kc-GitHub/MotorControl/Images/Motor_mit_Elektronik_2.jpg

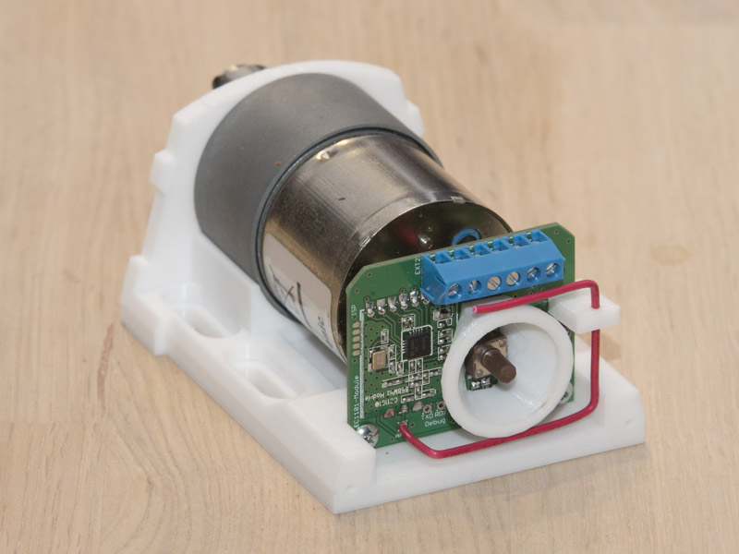
Images/Motor_mit_Elektronik_2.jpg
