kc-GitHub/MotorControl/Images/Vorhang_links.jpg

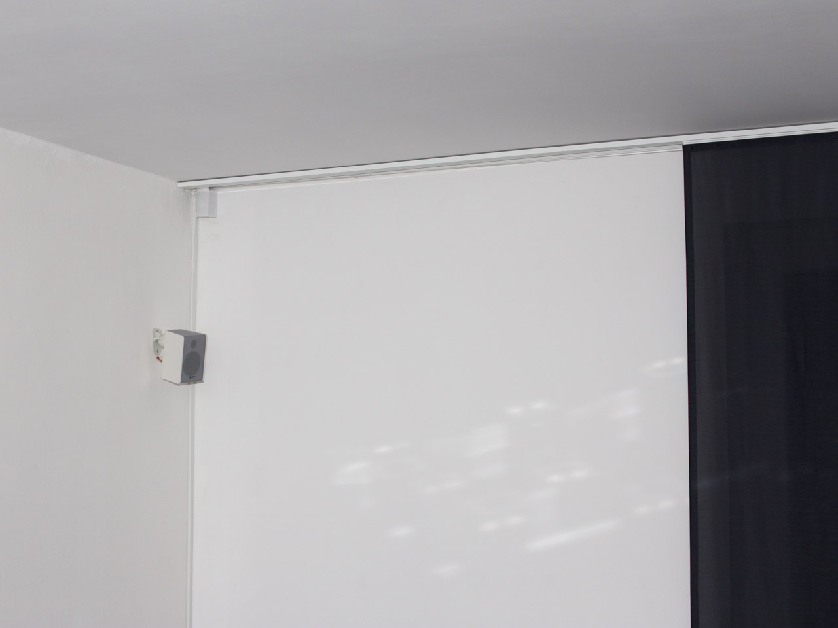
Images/Vorhang_links.jpg
