kc-GitHub/MotorControl/README.md

Firmware HM Motor-Control
===================================

#Changelog#

## First Version: 0.01 (Beta)##
 * First Commit
