kc-GitHub/MotorControl/Schematic/HM-Motor-Blind-Control_Schematic.pdf

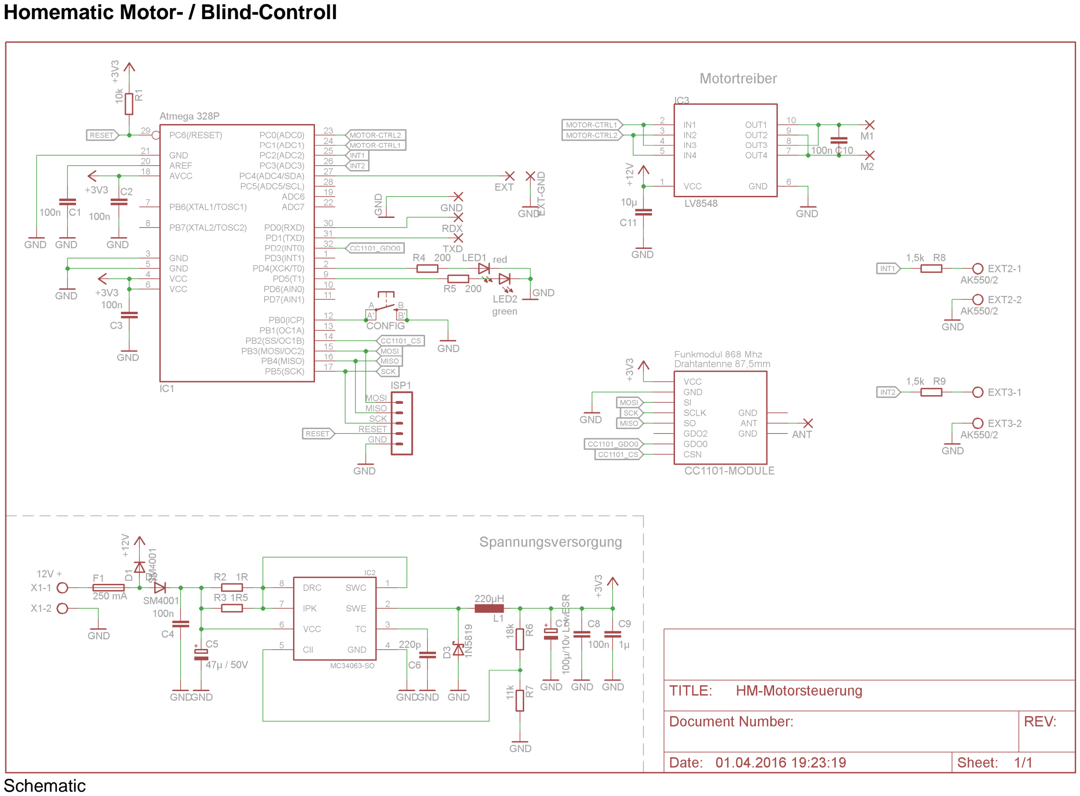
[picture p3: page 1]

Homematic Motor- / Blind-Controll

Schematic

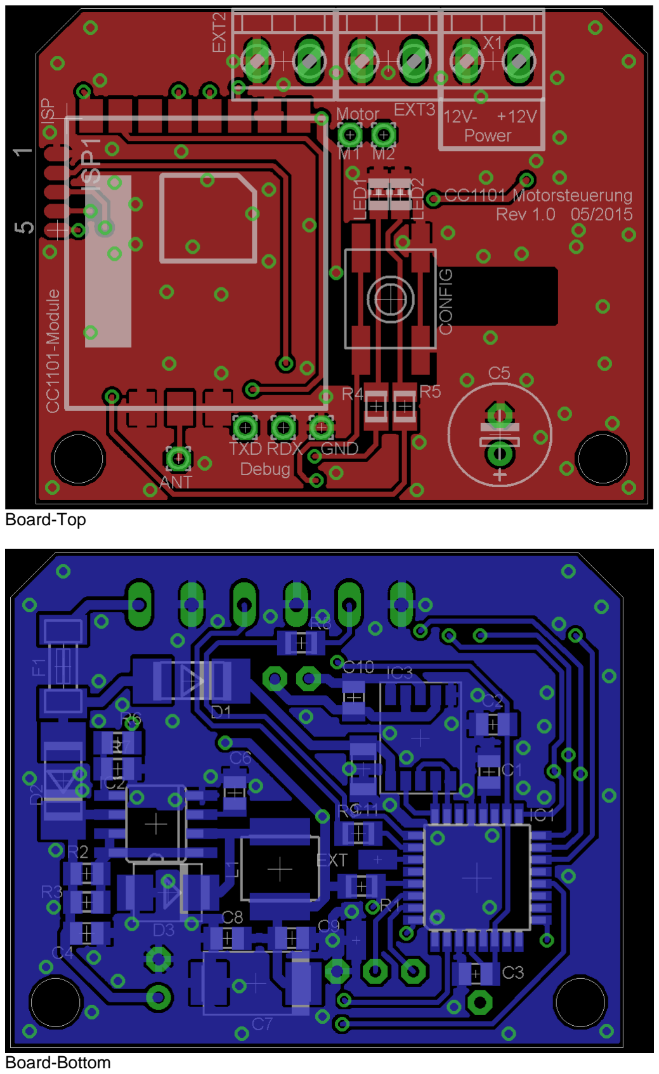
[picture p4: page 2]

Board-Top

Board-Bottom
