kc-GitHub/MotorControl/Images/Gehaeuse_Einzelteile.jpg

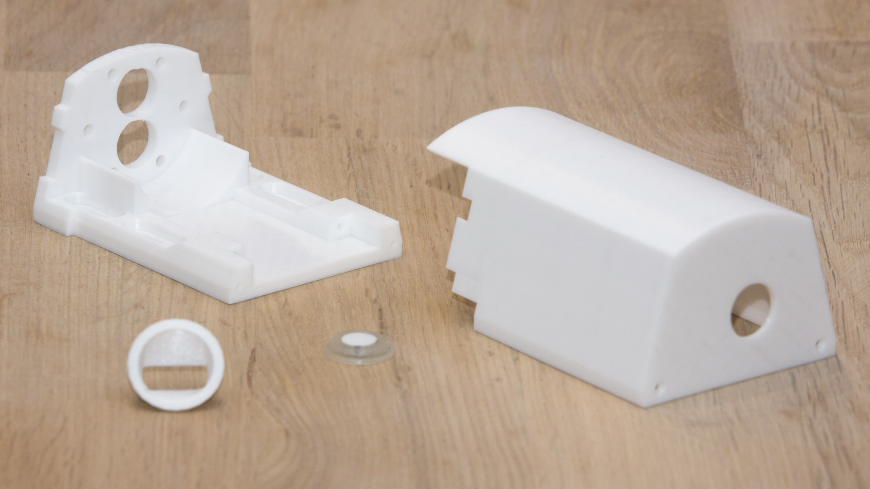
Images/Gehaeuse_Einzelteile.jpg
