kc-GitHub/MotorControl/Images/Gehaeuse_geschlossen.jpg

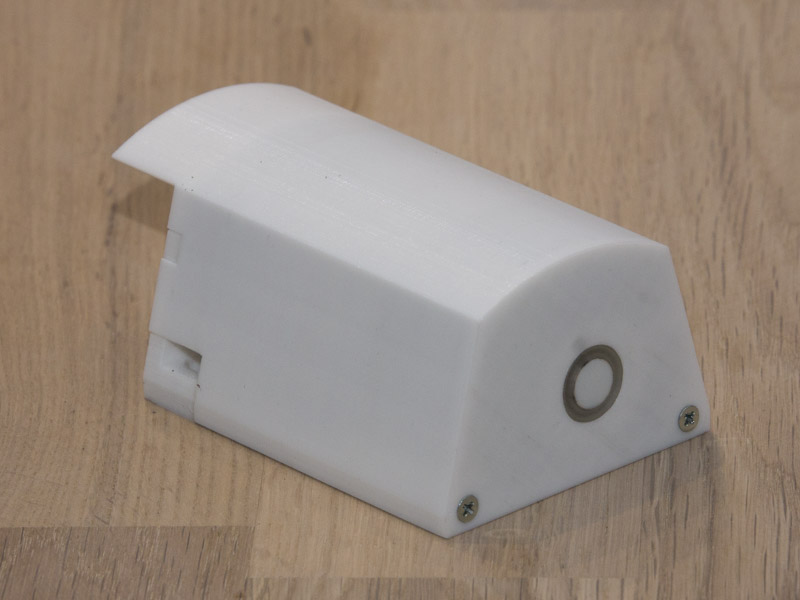
Images/Gehaeuse_geschlossen.jpg
