kc-GitHub/MotorControl/Images/Gehaeuse_geschlossen_rechts.jpg

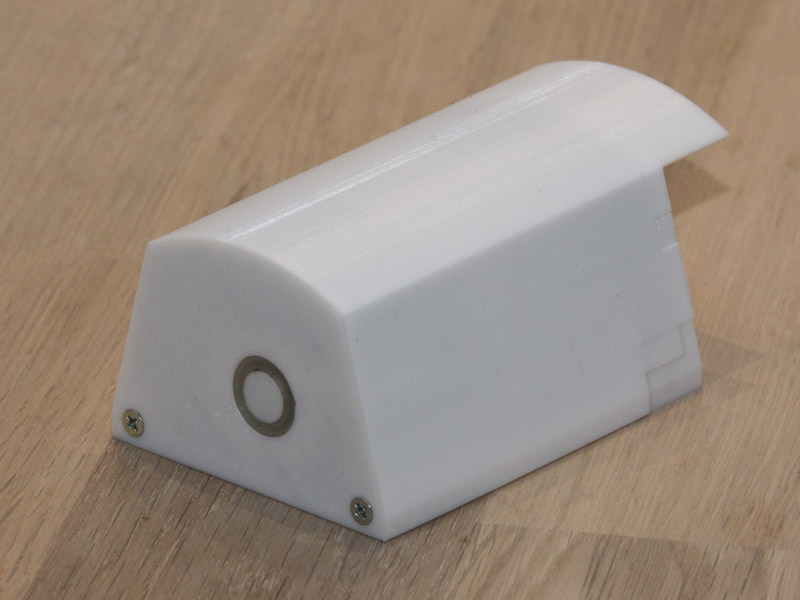
Images/Gehaeuse_geschlossen_rechts.jpg
