kc-GitHub/MotorControl/Images/Motor_mit_Elektronik.jpg

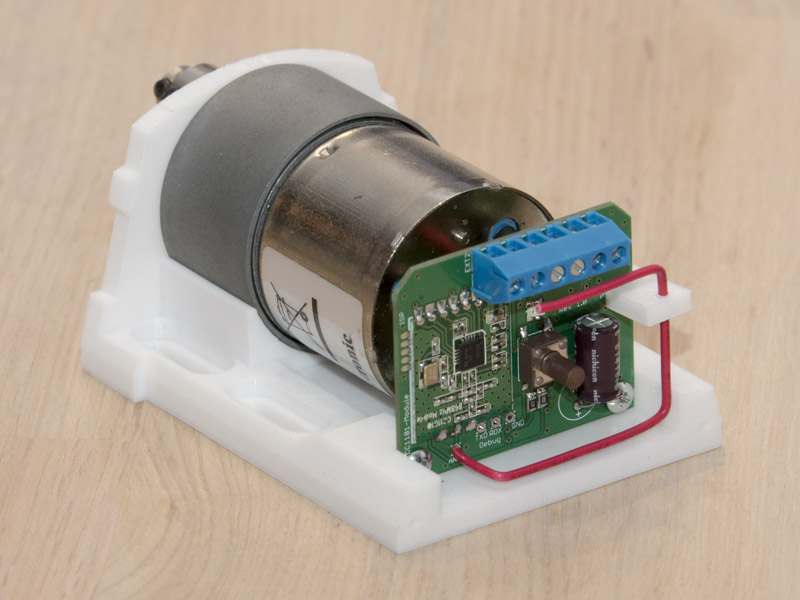
Images/Motor_mit_Elektronik.jpg
