kc-GitHub/MotorControl/Images/Motor_mit_Elektronik_3.jpg

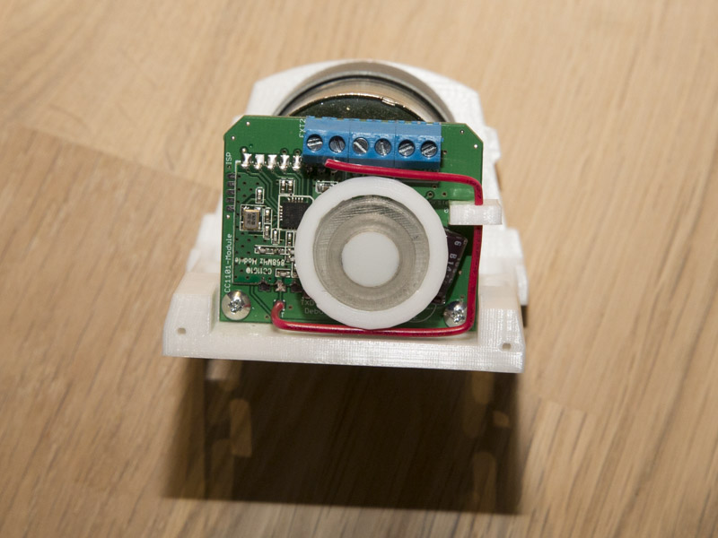
Images/Motor_mit_Elektronik_3.jpg
