kc-GitHub/MotorControl/Images/Motor_mit_Elektronik_vorn.jpg

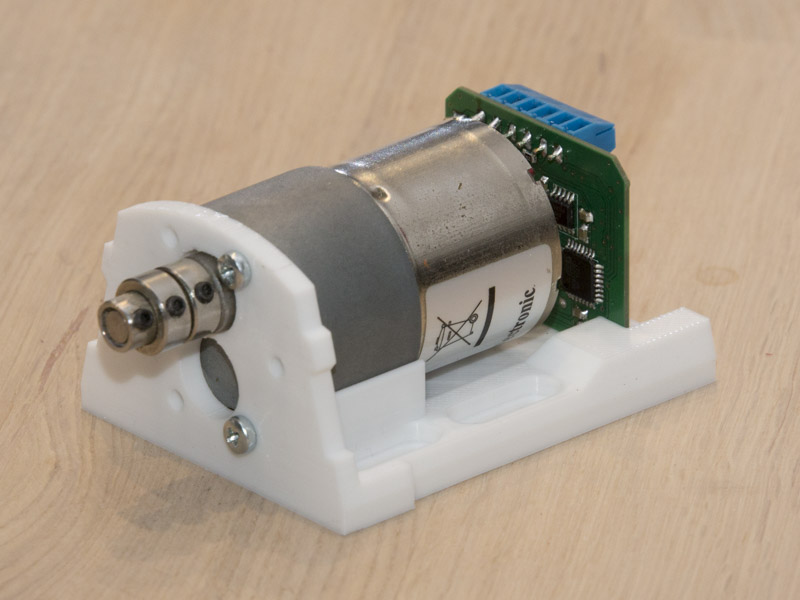
Images/Motor_mit_Elektronik_vorn.jpg
