kc-GitHub/MotorControl/Images/Motor_vorne.jpg

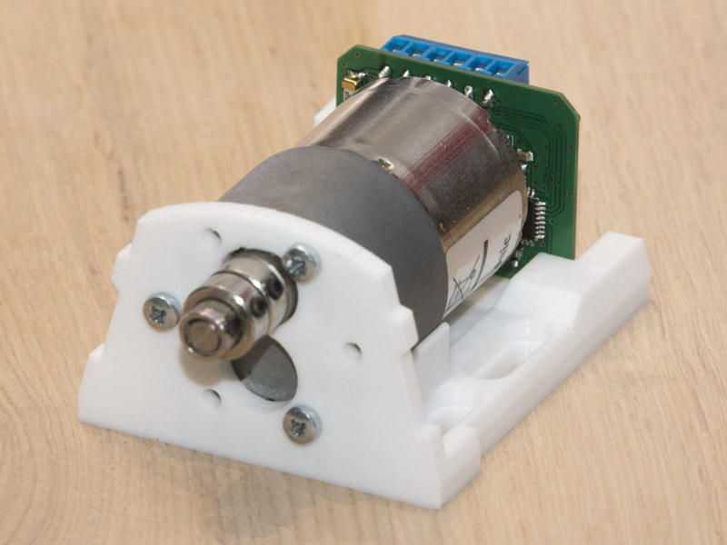
Images/Motor_vorne.jpg
