kc-GitHub/MotorControl/Images/Platine_Rueckseite.jpg

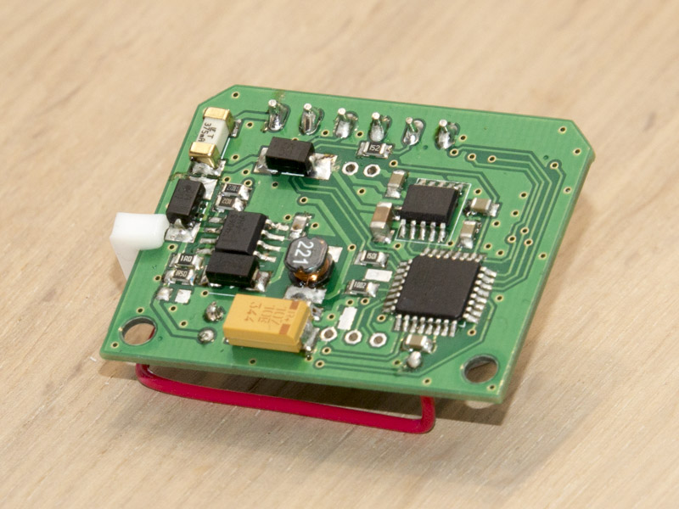
Images/Platine_Rueckseite.jpg
