kc-GitHub/MotorControl/Images/Platiner_oben.jpg

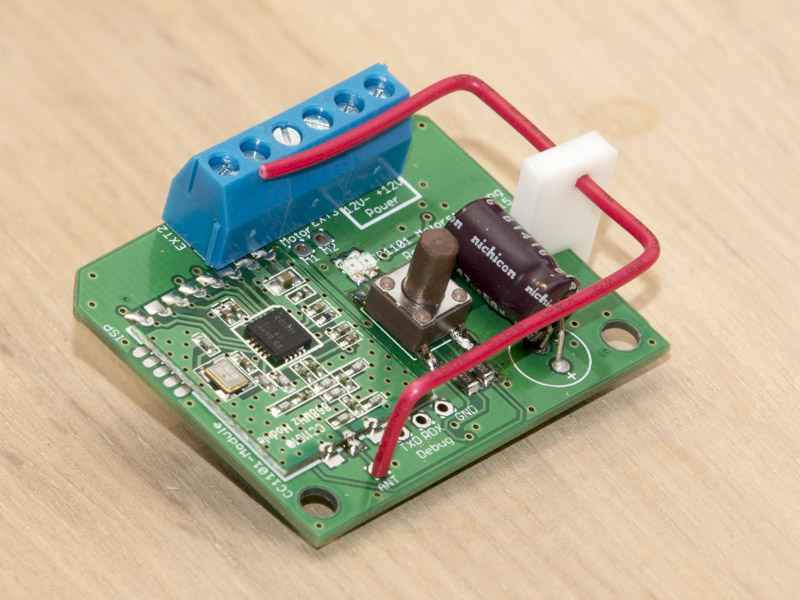
Images/Platiner_oben.jpg
