kc-GitHub/MotorControl/Images/Umlenkrolle.jpg

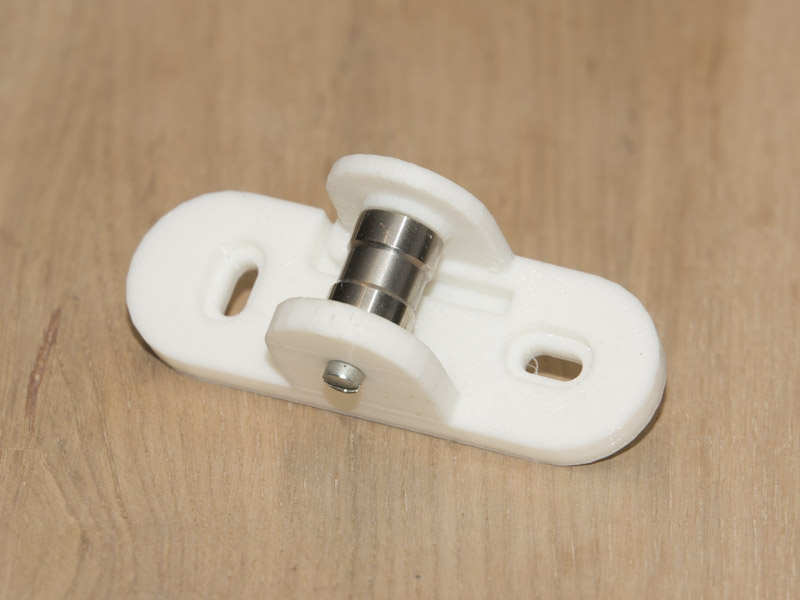
Images/Umlenkrolle.jpg
