kc-GitHub/MotorControl/Images/Umlenkrolle_mit_Reedkontakt.jpg

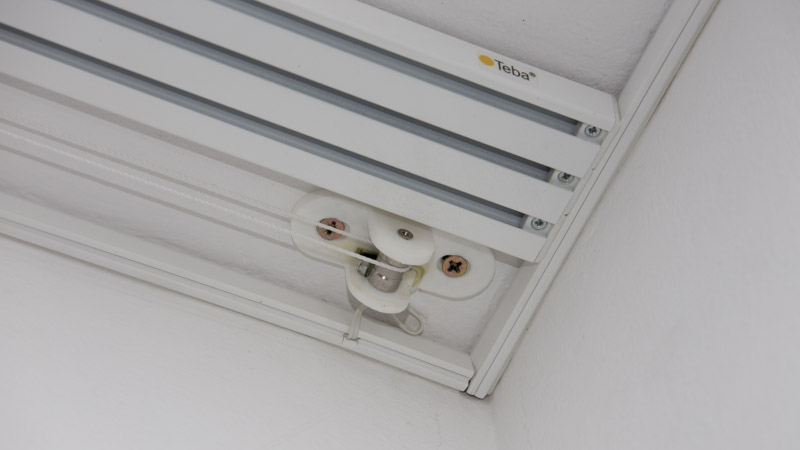
Images/Umlenkrolle_mit_Reedkontakt.jpg
