kc-GitHub/MotorControl/Images/Vorhang_rechts.jpg

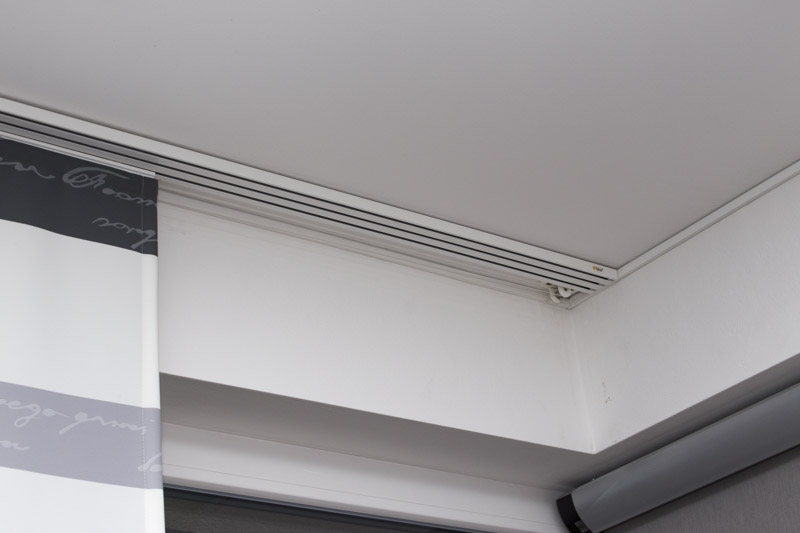
Images/Vorhang_rechts.jpg
