kc-GitHub/MotorControl/3D-PrintFiles/STL/Bearing-Holder.stl

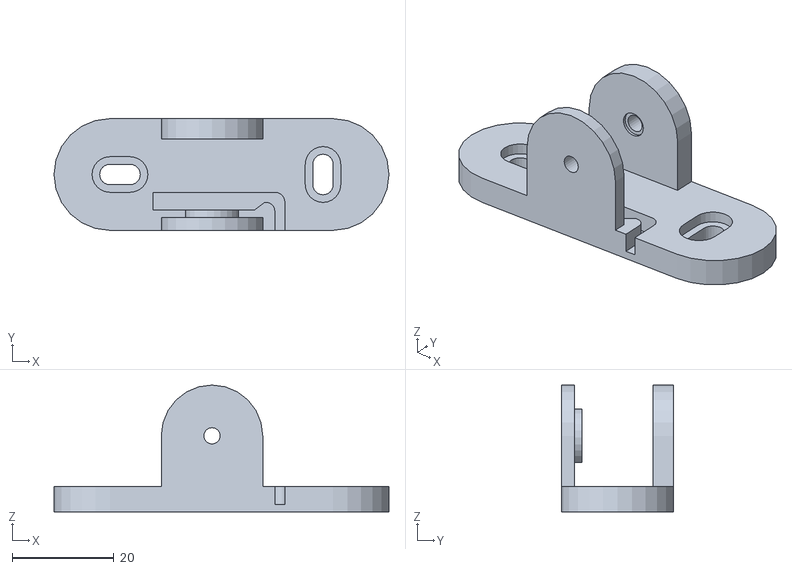
[picture p17: CAD file, 2016-04-04]
3D-PrintFiles/STL/Bearing-Holder.stl
66.0 x 22.0 x 25.0
