kc-GitHub/MotorControl/3D-PrintFiles/STL/BlindParts/Seilklemme.stl

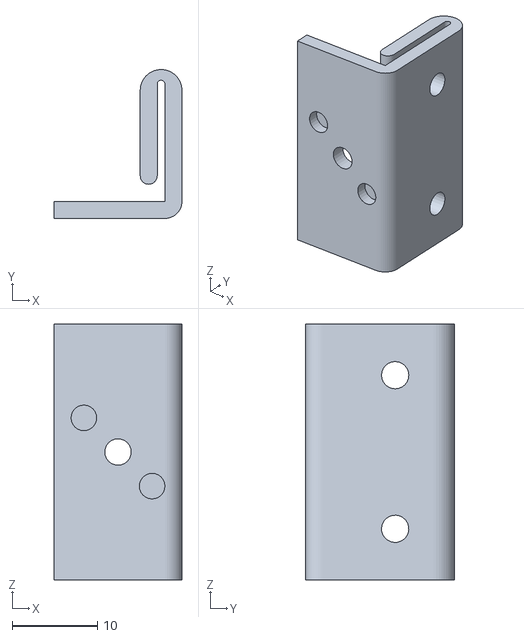
[picture p18: CAD file, 2016-04-04]
3D-PrintFiles/STL/BlindParts/Seilklemme.stl
15.0 x 17.4 x 30.0
