kc-GitHub/MotorControl/3D-PrintFiles/STL/MotorCase/Motor-Cover.stl

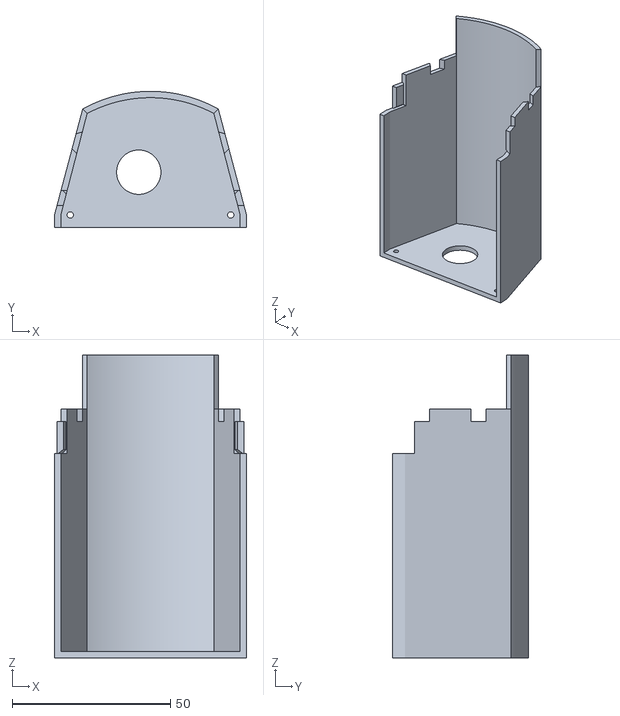
[picture p19: CAD file, 2016-04-04]
3D-PrintFiles/STL/MotorCase/Motor-Cover.stl
60.6 x 43.0 x 95.6
