kc-GitHub/MotorControl/3D-PrintFiles/STL/BlindParts/Mitnehmer_1_Magnethalter_rechts.stl

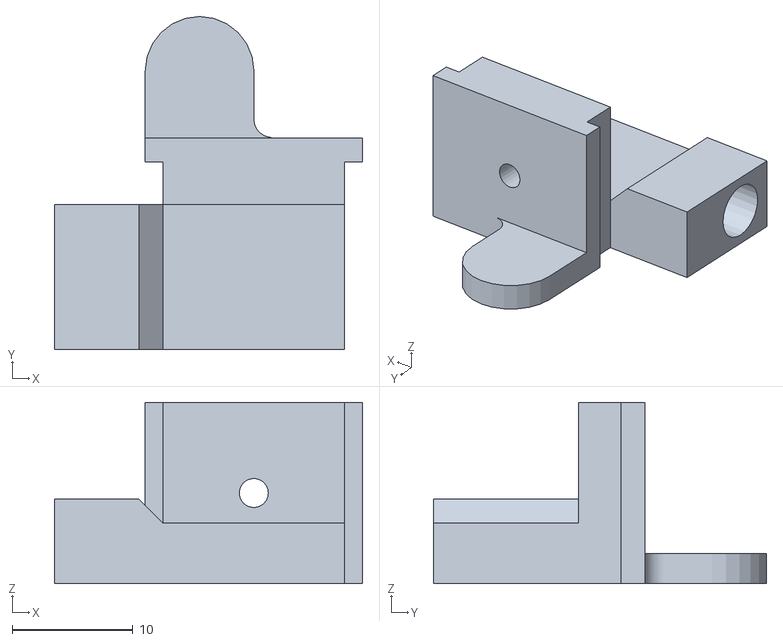
[picture p20: CAD file, 2016-04-04]
3D-PrintFiles/STL/BlindParts/Mitnehmer_1_Magnethalter_rechts.stl
25.5 x 27.5 x 15.0
