kc-GitHub/MotorControl/3D-PrintFiles/STL/MotorCase/LED-Cover.stl

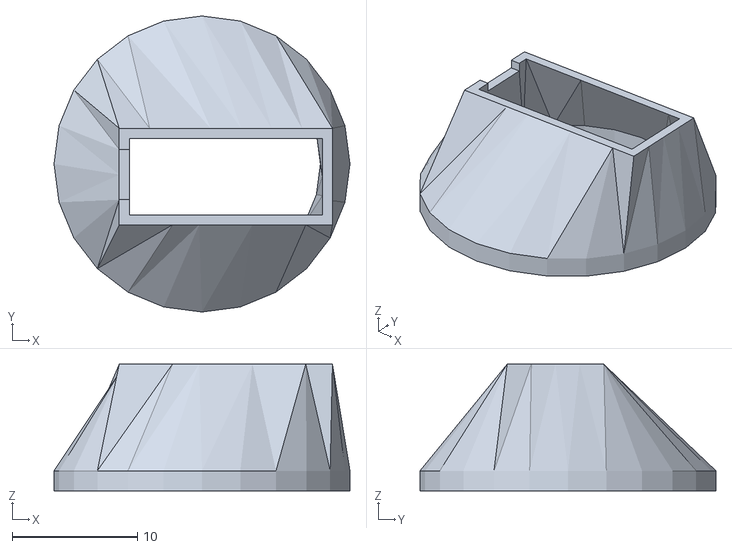
[picture p21: CAD file, 2016-04-04]
3D-PrintFiles/STL/MotorCase/LED-Cover.stl
23.6 x 23.6 x 10.1
