kc-GitHub/MotorControl/3D-PrintFiles/STL/BlindParts/Mitnehmer_2b.stl

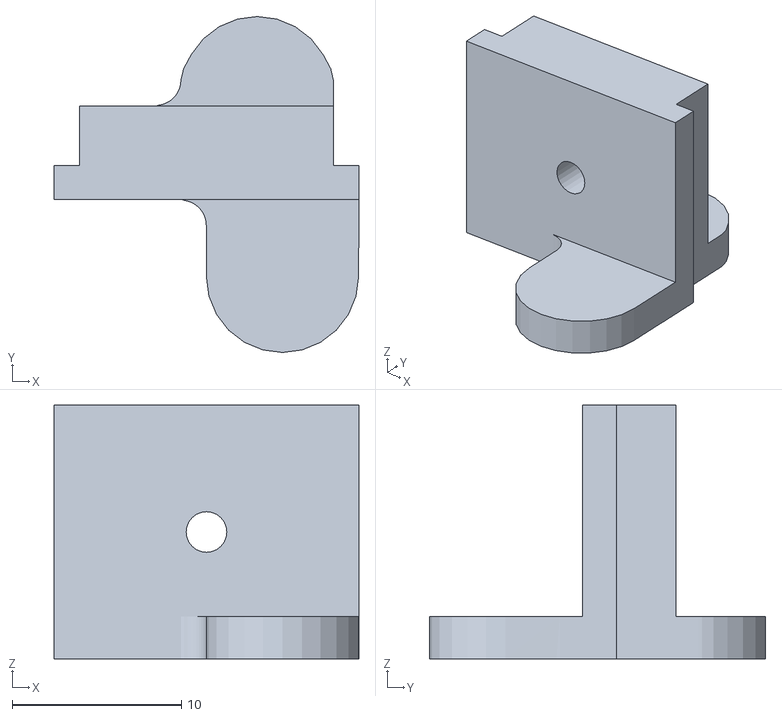
[picture p22: CAD file, 2016-04-04]
3D-PrintFiles/STL/BlindParts/Mitnehmer_2b.stl
18.0 x 19.9 x 15.0
