kc-GitHub/MotorControl/3D-PrintFiles/STL/MotorCase/Motor-Cover-Button-Inner.stl

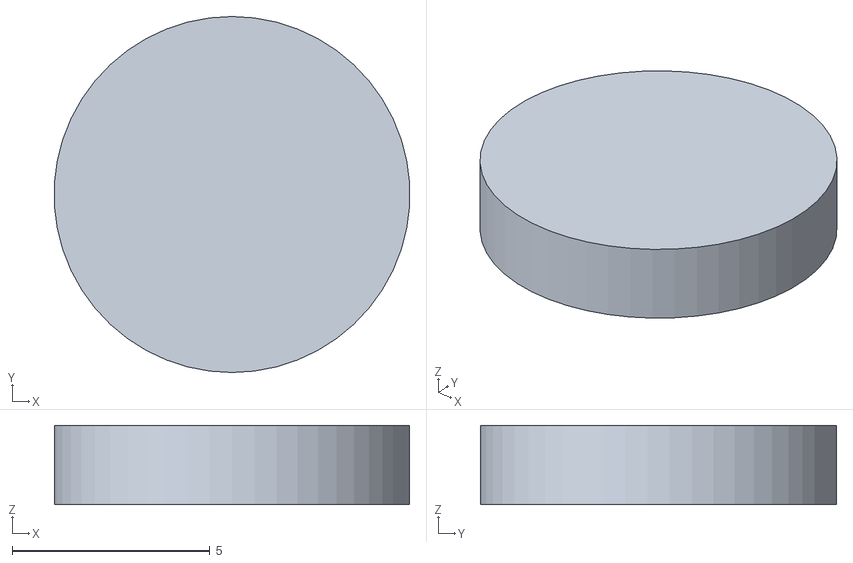
[picture p23: CAD file, 2016-04-04]
3D-PrintFiles/STL/MotorCase/Motor-Cover-Button-Inner.stl
8.98 x 9.00 x 2.00
