kc-GitHub/MotorControl/3D-PrintFiles/STL/BlindParts/Mitnehmer_2a.stl

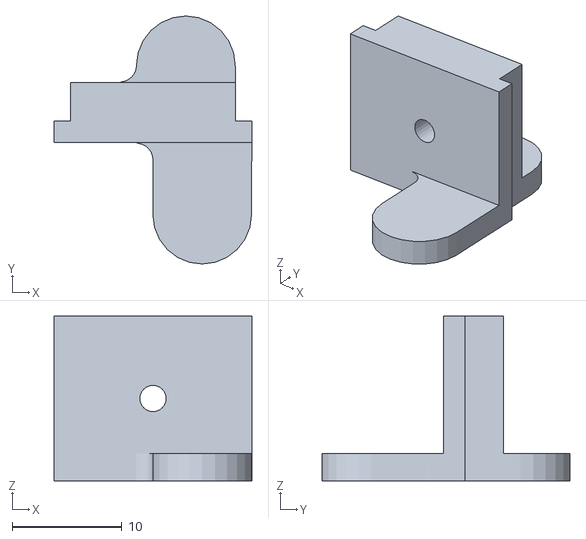
[picture p24: CAD file, 2016-04-04]
3D-PrintFiles/STL/BlindParts/Mitnehmer_2a.stl
18.0 x 22.6 x 15.0
