kc-GitHub/MotorControl/3D-PrintFiles/STL/MotorCase/MotorPlate.stl

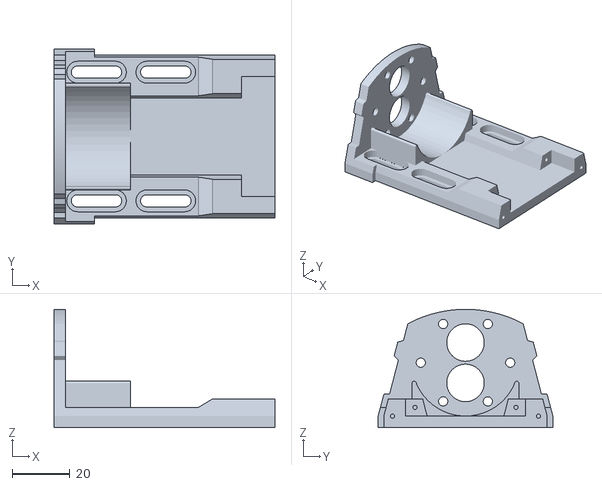
[picture p25: CAD file, 2016-04-04]
3D-PrintFiles/STL/MotorCase/MotorPlate.stl
76.6 x 60.6 x 41.0
