kc-GitHub/MotorControl/3D-PrintFiles/STL/BlindParts/all_for_4.stl

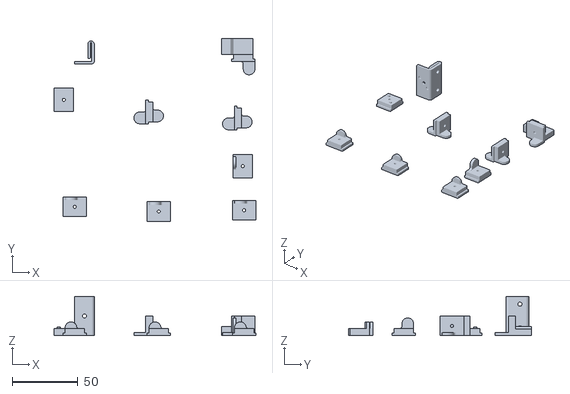
[picture p26: CAD file, 2016-04-04]
3D-PrintFiles/STL/BlindParts/all_for_4.stl
153.6 x 138.9 x 30.0
