kc-GitHub/MotorControl/3D-PrintFiles/STL/MotorCase/AntennaHolder.stl

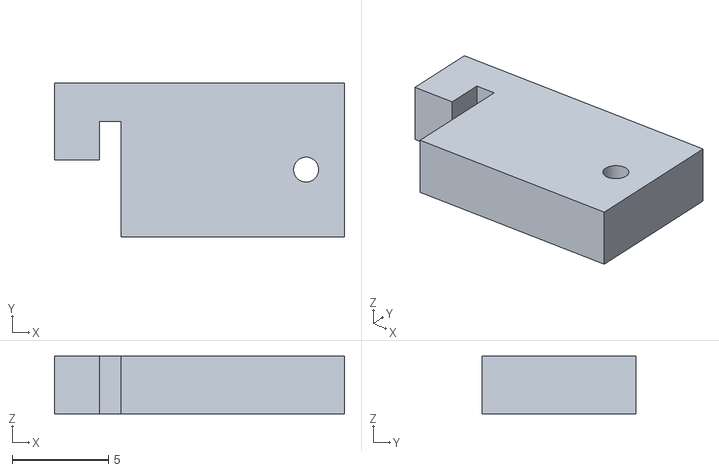
[picture p27: CAD file, 2016-04-04]
3D-PrintFiles/STL/MotorCase/AntennaHolder.stl
15.1 x 8.00 x 3.00
