kc-GitHub/MotorControl/3D-PrintFiles/STL/MotorCase/Motor-Cover-Button-Outer.stl

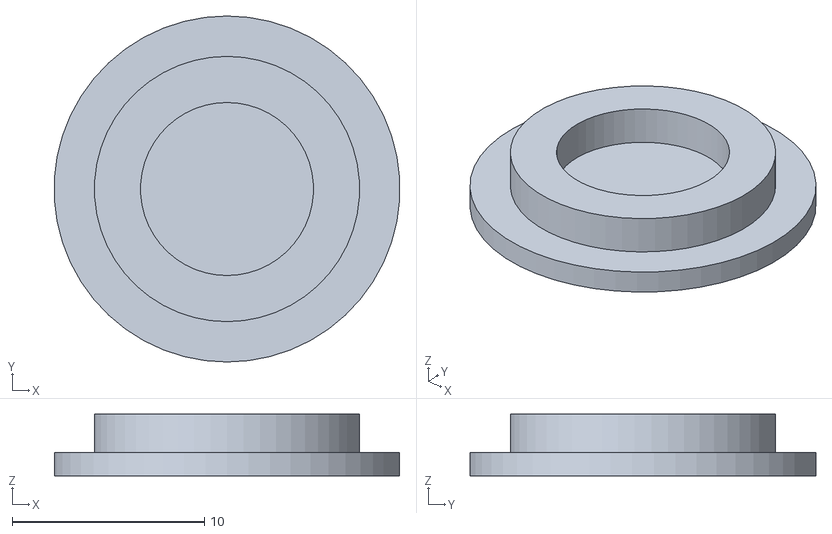
[picture p28: CAD file, 2016-04-04]
3D-PrintFiles/STL/MotorCase/Motor-Cover-Button-Outer.stl
18.0 x 18.0 x 3.20
