kc-GitHub/MotorControl/3D-PrintFiles/STL/BlindParts/Mitnehmer_3.stl

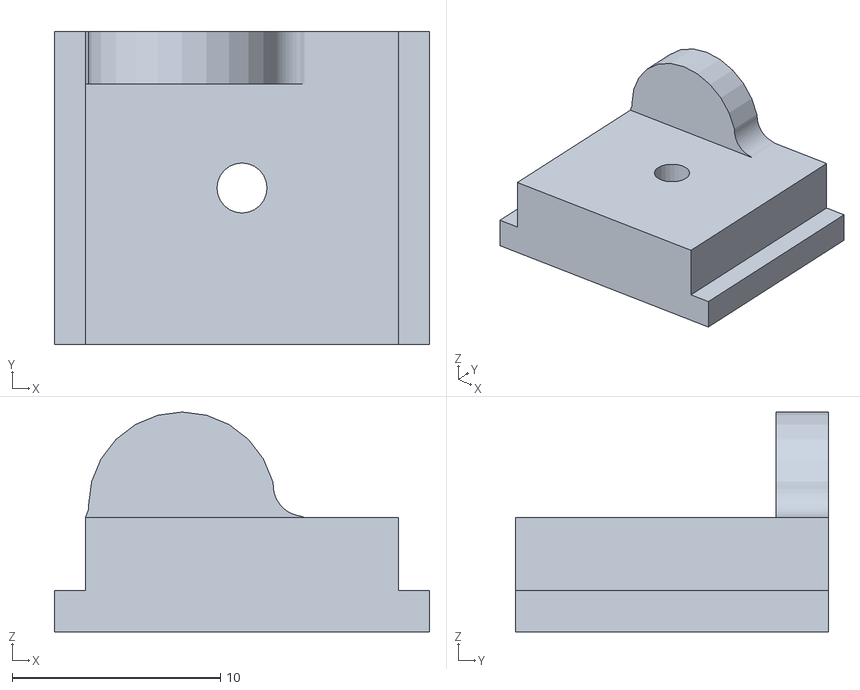
[picture p29: CAD file, 2016-04-04]
3D-PrintFiles/STL/BlindParts/Mitnehmer_3.stl
18.0 x 15.0 x 10.6
