kc-GitHub/MotorControl/3D-PrintFiles/STL/BlindParts/all_for_3.stl

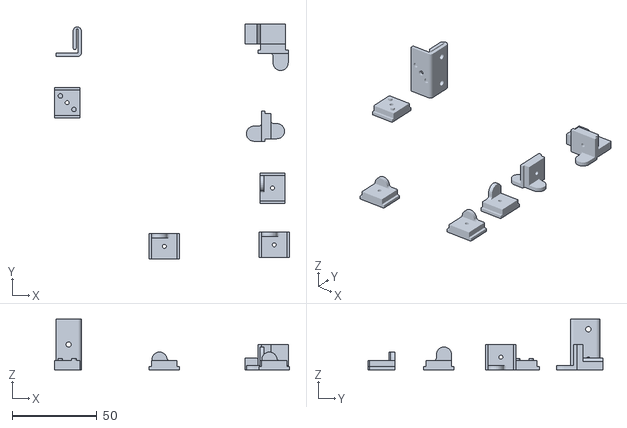
[picture p30: CAD file, 2016-04-04]
3D-PrintFiles/STL/BlindParts/all_for_3.stl
138.8 x 138.9 x 30.0
