kc-GitHub/MotorControl/3D-PrintFiles/STL/BlindParts/Sockel_Seilklemme.stl

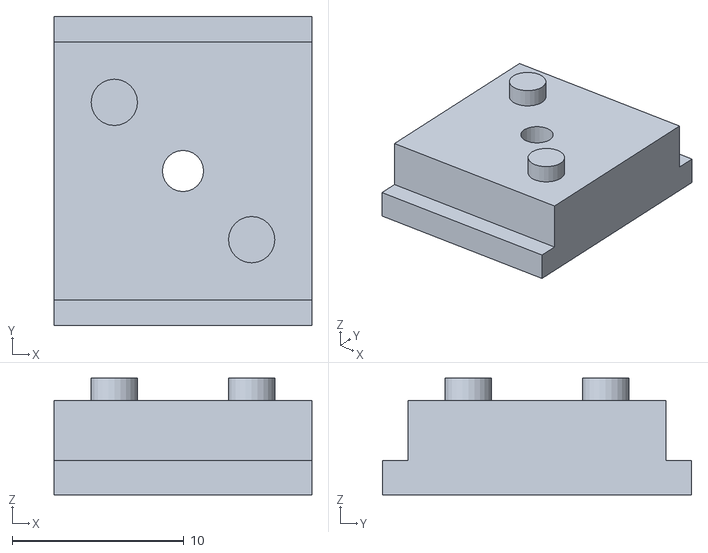
[picture p31: CAD file, 2016-04-04]
3D-PrintFiles/STL/BlindParts/Sockel_Seilklemme.stl
15.0 x 18.0 x 6.80
