kc-GitHub/MotorControl/(list of files, cad)

Other CAD files:
3D-PrintFiles/STL/BlindParts/Mitnehmer_1_Magnethalter_links.stl
3D-PrintFiles/Sketchup/Bearing-Holder.skp
3D-PrintFiles/Sketchup/Vorhangschie-Mitnehmer.skp
