kc-GitHub/MotorControl/Schematic/HM-Motorsteuerung.brd

## EAGLE design Schematic/HM-Motorsteuerung.brd (2016-04-03)

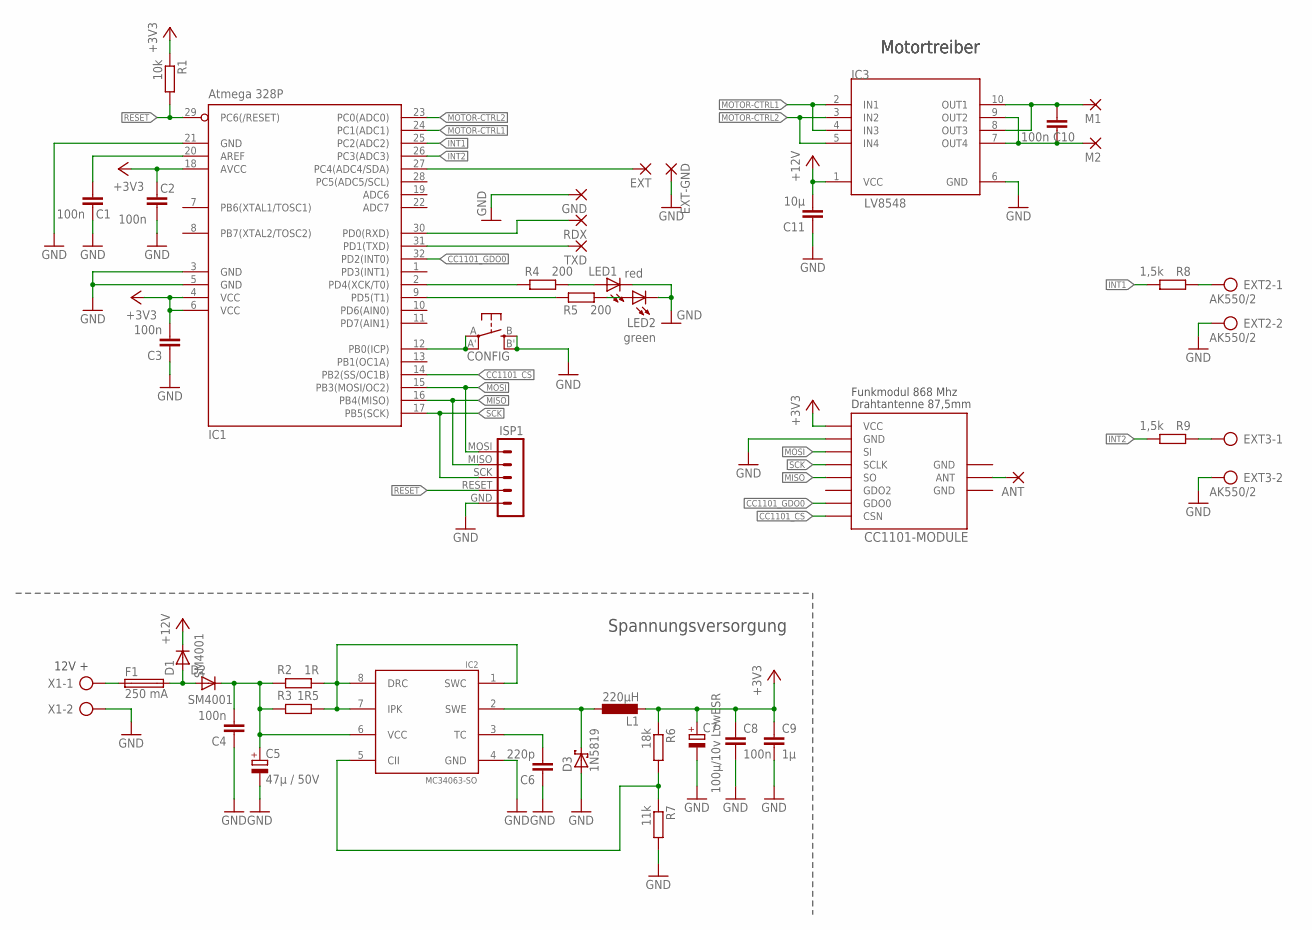
[picture p32: schematic HM-Motorsteuerung.sch]

Parts:
ANT: 1,6/0,8
C1, C2, C3, C4, C8, C10: 100n; C0805
C5: 47µ / 50V; E2,5-7
C6: 220p; C0805
C7: 100µ/10v LowESR; SMC_D
C9: 1µ; C0805
C11: 10µ; C1206
CC1101-MODULE: CC1101_WIRELES_MODULECC1101-SMD; CC1101
CONFIG: T1; EVQ-Q2
D1, D2: SM4001; MELF-MLL41
D3: 1N5819; SMB
EXT: WIREPADSMD1,27-254; SMD1,27-2,54
EXT2, EXT3: AK550/2
EXT-GND: WIREPADSMD1,27-254; SMD1,27-2,54
F1: 250 mA; SMD-6,1X2,6
GND: 1,6/0,8
IC1: Atmega 328P; TQFP32-08
IC2: MC34063-SO; SO8
IC3: LV8548; MFP10S; MPN LV8548MC-AH
ISP1: MYISPSMD; MYISP_SMD
L1: 220µH; L5650M
LED1: red; CHIP-LED0805
LED2: green; CHIP-LED0805
M1, M2: 1,6/0,8
R1: 10k; M0805
R2: 1R; R0805
R3: 1R5; R0805
R4, R5: 200; M0805
R6: 18k; R0805
R7: 11k; R0805
R8, R9: 1,5k; M0805
RDX: 1,6/0,8
TXD: 1,6/0,8
X1: AK550/2

Connections:
+3V3: C2.2, C3.2, C7.+, C8.1, C9.1, CC1101-MODULE.VCC, IC1.4 (VCC), IC1.6 (VCC), IC1.18 (AVCC), L1.2, R1.1, R6.1
CC1101_CS: CC1101-MODULE.CSN, IC1.14 (PB2(SS/OC1B))
CC1101_GDO0: CC1101-MODULE.GD00 (GDO0), IC1.32 (PD2(INT0))
D4: IC1.2 (PD4(XCK/T0)), R4.1
D8: CONFIG.A, CONFIG.A' (P1), IC1.12 (PB0(ICP))
GND: C1.1, C2.1, C3.1, C4.1, C5.-, C6.1, C7.-, C8.2, C9.2, C11.1, CC1101-MODULE.GND, CC1101-MODULE.GND_0 (GND), CC1101-MODULE.GND_1 (GND), CONFIG.B (S), CONFIG.B' (S1), D3.A, EXT2.2, EXT3.2, EXT-GND.1, GND.1, IC1.3 (GND), IC1.5 (GND), IC1.21 (GND), IC2.4 (GND), IC3.6 (GND), ISP1.GND, LED1.C, LED2.C, R7.2, X1.2
INT1: IC1.25 (PC2(ADC2)), R8.2
INT2: IC1.26 (PC3(ADC3)), R9.2
MISO: CC1101-MODULE.SO, IC1.16 (PB4(MISO)), ISP1.MISO
MOSI: CC1101-MODULE.SI, IC1.15 (PB3(MOSI/OC2)), ISP1.MOSI
MOTOR-CTRL1: IC1.24 (PC1(ADC1)), IC3.2 (IN1), IC3.4 (IN3)
MOTOR-CTRL2: IC1.23 (PC0(ADC0)), IC3.3 (IN2), IC3.5 (IN4)
unnamed: F1.1, X1.1
unnamed: EXT2.1, R8.1
unnamed: LED2.A, R5.2
unnamed: LED1.A, R4.2
unnamed: ANT.1, CC1101-MODULE.ANT
unnamed: EXT3.1, R9.1
unnamed: C10.2, IC3.8 (OUT3), IC3.10 (OUT1), M1.1
unnamed: C10.1, IC3.7 (OUT4), IC3.9 (OUT2), M2.1
unnamed: IC1.9 (PD5(T1)), R5.1
unnamed: EXT.1, IC1.27 (PC4(ADC4/SDA))
unnamed: C1.2, IC1.20 (AREF)
unnamed: D1.A, D2.A, F1.2
unnamed: IC2.1 (SWC), IC2.7 (IPK), IC2.8 (DRC), R2.1, R3.1
unnamed: C4.2, C5.+, D2.C, IC2.6 (VCC), R2.2, R3.2
unnamed: IC2.5 (CII), R6.2, R7.1
unnamed: C6.2, IC2.3 (TC)
unnamed: D3.C, IC2.2 (SWE), L1.1
RESET: IC1.29 (PC6(/RESET)), ISP1.RESET, R1.2
RXD: IC1.30 (PD0(RXD)), RDX.1
SCK: CC1101-MODULE.SCLK, IC1.17 (PB5(SCK)), ISP1.SCK
TXD: IC1.31 (PD1(TXD)), TXD.1
VCC-MOTOR: C11.2, D1.C, IC3.1 (VCC)

Notes on the sheet:
12V +
Spannungsversorgung
Funkmodul 868 Mhz
Drahtantenne 87,5mm
Motortreiber

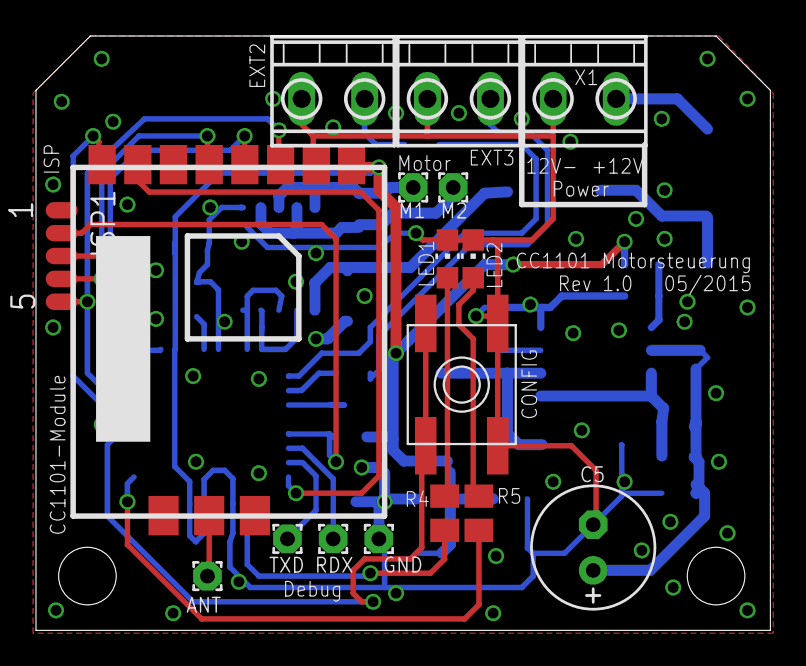
[picture p33: board HM-Motorsteuerung.brd from above]

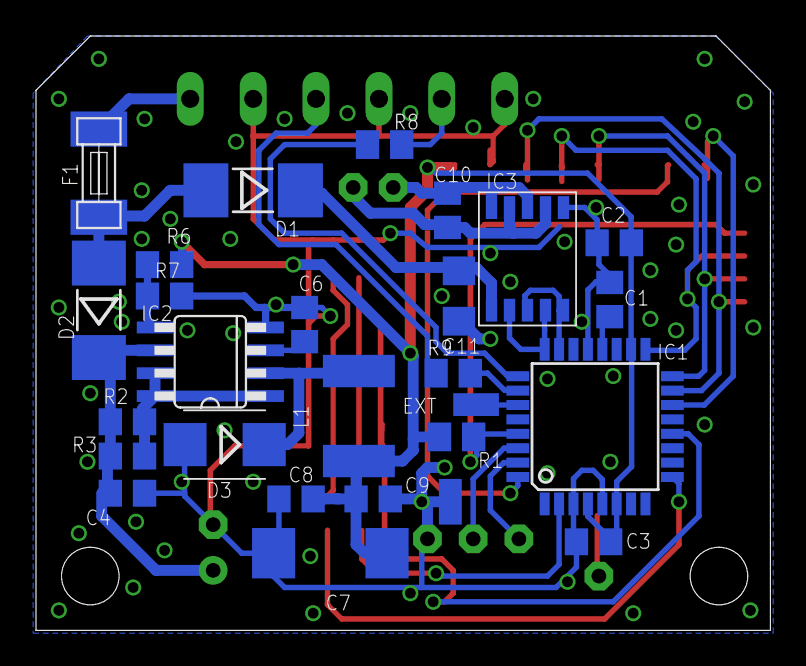
[picture p34: board HM-Motorsteuerung.brd from below]

Board: 2 copper layers, 40.8 x 33.0 mm, 44 parts (27 on the bottom side), 34 nets.
