kc-GitHub/MotorControl/(commit log)

2016-04-03 Fix Overflow of REFERENCE_RUNNING_TIME_BOTTOM_TOP Reverse motor direction Motor stop after 1 seconds without impulses
    [HM-LC-Bl1-FM_AES.ino, register.h]
2016-04-03 Add Schematic
    [HM-Motorsteuerung.brd, HM-Motorsteuerung.sch]
2016-04-04 Add 3D-Print-Files
    [AntennaHolder.stl, Bearing-Holder.skp, Bearing-Holder.stl, LED-Cover.stl, Mitnehmer_1_Magnethalter_left.stl, Mitnehmer_1_Magnethalter_rechts.stl, Mitnehmer_2a.stl, Mitnehmer_2a_old.stl]
2016-04-04 Update STL-Files
    [LED-Cover.stl, Motor-Cover.stl]
2016-04-06 - increase debounce time - add own ISR PCINT1_vect for counting impulses and detect end switch - rework impulse counting and end switch detection - implement processing of stop _change message - clea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
    [HM-LC-Bl1-FM_AES.ino]
2016-04-06 - decrease send status intervall while running to 2 seconds - fix send status - fix wrong send status after pressed peered remote keys
    [HM-LC-Bl1-FM_AES.ino]
2016-04-07 Change definition of travelMax to int16_t add motorbreak at stop
2016-04-07 make shure position can not > 100% so prevent overflow to 0xFF
    [HM-LC-Bl1-FM_AES.ino]
2016-04-08 remember last position and state in eeprom so we can get this values after switch power off
2016-04-09 Add option to reverse the motor direction
    [HM-LC-Bl1-FM_AES.ino]
2016-04-14 Implement processing of action commands (set, switch remote, ...) in AES mode
2016-04-15 Fix bugs on travel counting
    [HM-LC-Bl1-FM_AES.ino]
